sasada-cam/racklift5/models/v3/components/README.md

# RackLift5 v3 - component list

129 unique parts, one STEP + STL each (mm, bounding-box corner at the origin; bought parts are simplified envelopes). Quantities are for the whole system: 3 rows x 4 racks, 3 docks, 1 cart, 1 robot. Generated by `cad/export_v3_components.py`; see also `models/v3/assembly/` for the assembled poses.

## Baskets

| ID | part | qty | size mm | process / source |
|---|---|---|---|---|
| BAS01 | basket (stand-in for the real basket) | 55 | 260 x 180 x 110 | Buy (basket) |

## Covers

| ID | part | qty | size mm | process / source |
|---|---|---|---|---|
| COV01 | cover: front drive (servo 1 + belt) | 1 | 58 x 55 x 58 | 3D print (PETG), 2.4 mm walls, closed face down |
| COV02 | cover: jack motor | 3 | 71 x 66 x 56 | 3D print (PETG), 2.4 mm walls, closed face down |
| COV03 | cover: turn-drive cap | 1 | 47 x 36 x 46 | 3D print (PETG), 2.4 mm walls, closed face down |

## Dock (jack + raised floor)

| ID | part | qty | size mm | process / source |
|---|---|---|---|---|
| DOC01 | jack: NEMA17 stepper + 3:1 planetary gearhead | 3 | 73 x 42 x 42 | Buy (actuator) |
| DOC02 | jack: TR8x2 lead screw | 3 | 170 x 10 x 10 | Buy (TR8x2 lead screw) |
| DOC03 | jack: base plate (aluminium) | 3 | 270 x 214 x 6 | Aluminium plate / bar (laser cut, drill) |
| DOC04 | jack: bottom pivot lug | 6 | 16 x 8 x 16 | 3D print (PETG) |
| DOC05 | jack: bottom pivot shaft (fixed) | 3 | 6 x 167 x 6 | Steel rod / tube (cut, turn) |
| DOC06 | jack: centre pin shaft | 3 | 6 x 168 x 6 | Steel rod / tube (cut, turn) |
| DOC07 | jack: lead nut block (printed) | 3 | 16 x 16 x 21 | 3D print (PETG) |
| DOC08 | jack: limit switch (platform down) | 3 | 8 x 10 x 14 | Buy (sensor / switch) |
| DOC09 | jack: limit switch (platform up) | 3 | 8 x 10 x 14 | Buy (sensor / switch) |
| DOC10 | jack: motor bracket (printed) | 3 | 6 x 66 x 56 | 3D print (PETG) |
| DOC11 | jack: platform plate (8 mm aluminium) | 3 | 290 x 236 x 17 | Aluminium plate / bar (laser cut, drill) |
| DOC12 | jack: roller | 6 | 12 x 3 x 12 | Buy (wheel / roller) |
| DOC13 | jack: roller axle | 3 | 4 x 165 x 4 | Steel rod / tube (cut, turn) |
| DOC14 | jack: roller guide bar | 6 | 104 x 4 x 16 | Steel / aluminium flat bar (cut, drill) |
| DOC15 | jack: scissor arm (inner) | 6 | 184 x 8 x 14 | Aluminium flat bar 14 x 8 (cut, drill) |
| DOC16 | jack: scissor arm (outer) | 6 | 184 x 8 x 14 | Aluminium flat bar 14 x 8 (cut, drill) |
| DOC17 | jack: screw bearing block (printed) | 3 | 8 x 24 x 28 | 3D print (PETG) |
| DOC18 | jack: shaft coupling + index flag | 3 | 10 x 16 x 34 | Print, or buy a GT2 pulley / gear / coupling |
| DOC19 | jack: slider cross tube | 3 | 8 x 165 x 8 | Steel rod / tube (cut, turn) |
| DOC20 | jack: slider guide rail | 6 | 118 x 6 x 4 | Steel / aluminium flat bar (cut, drill) |
| DOC21 | jack: slider shoe (printed) | 6 | 24 x 6 x 11 | 3D print (PETG) |
| DOC22 | jack: top pivot lug | 6 | 16 x 6 x 16 | 3D print (PETG) |
| DOC23 | jack: top pivot shaft | 3 | 6 x 163 x 6 | Steel rod / tube (cut, turn) |
| DOC24 | raised floor: battens | 3 | 399 x 424 x 20 | Timber battens (cut) |
| DOC25 | raised floor: top plate (18 mm plywood) | 3 | 399 x 424 x 18 | Plywood (cut to size) |

## Locks (robot + cart)

| ID | part | qty | size mm | process / source |
|---|---|---|---|---|
| LCK01 | cart docking bar (printed, with the bolt socket) | 1 | 116 x 28 x 28 | 3D print (PETG) |
| LCK02 | cart lock pin + release tab (spring) | 1 | 40 x 74 x 40 | Steel rod / tube (cut, turn) |
| LCK03 | cart lock socket (printed, funnel lead-in, on the lower rail-end arm) | 3 | 30 x 26 x 65 | 3D print (PETG) |
| LCK04 | lock solenoid (docking bolt, push type) | 1 | 18 x 28 x 16 | Buy (actuator) |
| LCK05 | lock solenoid (release plunger, push type) | 1 | 28 x 21 x 16 | Buy (actuator) |
| LCK06 | lock solenoid bolt (docking, bullet nose) | 1 | 9 x 14 x 9 | Steel rod / tube (cut, turn) |
| LCK07 | lock solenoid bracket (docking bolt) | 1 | 24 x 6 x 24 | 3D print (PETG) |
| LCK08 | lock solenoid bracket (release plunger) | 1 | 36 x 6 x 24 | 3D print (PETG) |
| LCK09 | lock solenoid plunger (cart release) | 1 | 48 x 4 x 4 | Steel rod / tube (cut, turn) |

## Rack

| ID | part | qty | size mm | process / source |
|---|---|---|---|---|
| RAC01 | slotted angle rack (bay) | 12 | 382 x 234 x 1000 | Buy (slotted-angle rack) |

## Rails + crossings

| ID | part | qty | size mm | process / source |
|---|---|---|---|---|
| RAI01 | 50 mm turntable bearing | 24 | 50 x 8 x 50 | Buy (bearing) |
| RAI02 | V-slot rail (horizontal) | 18 | 324 x 20 x 20 | Aluminium extrusion (cut to length) |
| RAI03 | V-slot rail (horizontal) | 6 | 489 x 20 x 20 | Aluminium extrusion (cut to length) |
| RAI04 | V-slot rail (vertical) | 12 | 20 x 20 x 694 | Aluminium extrusion (cut to length) |
| RAI05 | V-slot rail (vertical, between crossings) | 12 | 20 x 20 x 145 | Aluminium extrusion (cut to length) |
| RAI06 | aluminium crossing bracket | 6 | 57 x 40 x 40 | Aluminium plate / bar (laser cut, drill) |
| RAI07 | aluminium crossing bracket | 18 | 182 x 40 x 40 | Aluminium plate / bar (laser cut, drill) |
| RAI08 | aluminium rail support (last stretch) | 6 | 38 x 40 x 40 | Aluminium plate / bar (laser cut, drill) |
| RAI09 | printed in-slot rack | 36 | 10 x 4 x 188 | Print fine (0.12 mm, 100 % infill) or order nylon (SLS) |
| RAI10 | printed in-slot rack | 30 | 10 x 4 x 188 | Print fine (0.12 mm, 100 % infill) or order nylon (SLS) |
| RAI11 | printed in-slot rack | 12 | 10 x 4 x 129 | Print fine (0.12 mm, 100 % infill) or order nylon (SLS) |
| RAI12 | printed in-slot rack | 12 | 10 x 4 x 145 | Print fine (0.12 mm, 100 % infill) or order nylon (SLS) |
| RAI13 | printed in-slot rack | 18 | 136 x 4 x 10 | Print fine (0.12 mm, 100 % infill) or order nylon (SLS) |
| RAI14 | printed in-slot rack | 6 | 113 x 4 x 10 | Print fine (0.12 mm, 100 % infill) or order nylon (SLS) |
| RAI15 | printed in-slot rack (cart) | 2 | 112 x 4 x 10 | Print fine (0.12 mm, 100 % infill) or order nylon (SLS) |
| RAI16 | printed in-slot rack (turntable) | 24 | 10 x 4 x 112 | Print fine (0.12 mm, 100 % infill) or order nylon (SLS) |
| RAI17 | printed rail bridge | 36 | 122 x 40 x 40 | 3D print (PETG) |
| RAI18 | rail end arm (from the rack end post) | 6 | 125 x 30 x 24 | Aluminium extrusion (cut to length) |
| RAI19 | rail piece on cart | 2 | 112 x 20 x 20 | Aluminium extrusion (cut to length) |
| RAI20 | rail piece on turntable | 24 | 20 x 20 x 112 | Aluminium extrusion (cut to length) |

## Robot body + hubs

| ID | part | qty | size mm | process / source |
|---|---|---|---|---|
| ROB01 | JGY-370 climb motor | 2 | 22 x 36 x 32 | Buy (actuator) |
| ROB02 | JGY-370 climb motor can | 2 | 24 x 24 x 30 | Buy (actuator) |
| ROB03 | JGY-370 swivel motor | 2 | 22 x 22 x 46 | Buy (actuator) |
| ROB04 | JGY-370 swivel motor can | 2 | 33 x 24 x 24 | Buy (actuator) |
| ROB05 | PTFE slide pad | 8 | 2 x 180 x 4 | Buy (PTFE pad) |
| ROB06 | V wheel | 8 | 24 x 10 x 24 | Buy (wheel / roller) |
| ROB07 | aluminium column bar 28 x 24 (replaces the printed column) | 1 | 28 x 24 x 299 | Aluminium bar 28 x 24 (cut to length, drill) |
| ROB08 | battery + electronics box (fixed counterweight) | 1 | 100 x 60 x 90 | Buy (battery + electronics box) |
| ROB09 | battery bracket | 1 | 56 x 24 x 30 | Aluminium plate / bar (laser cut, drill) |
| ROB10 | climber shaft | 2 | 13 x 6 x 6 | Steel rod / tube (cut, turn) |
| ROB11 | hub plate (6 mm aluminium) | 2 | 65 x 6 x 90 | Aluminium plate / bar (laser cut, drill) |
| ROB12 | printed climber pinion | 2 | 11 x 24 x 24 | Print fine (0.12 mm, 100 % infill) or order nylon (SLS) |
| ROB13 | printed hub cover | 2 | 94 x 12 x 94 | 3D print (PETG) |
| ROB14 | spacer | 8 | 10 x 6 x 10 | Steel rod / tube (cut, turn) |
| ROB15 | swivel axle | 2 | 16 x 29 x 16 | Steel rod / tube (cut, turn) |

## Transfer cart + beam

| ID | part | qty | size mm | process / source |
|---|---|---|---|---|
| CRT01 | cart frame (20x20 V-slot) | 1 | 126 x 280 x 408 | Aluminium extrusion (cut to length) |
| CRT02 | cart trolley plate | 2 | 8 x 44 x 88 | Aluminium plate / bar (laser cut, drill) |
| CRT03 | floor guide rail (guides only, no load) | 1 | 20 x 2040 x 20 | Aluminium extrusion (cut to length) |
| CRT04 | floor guide rollers (sideways only) | 2 | 36 x 16 x 20 | Buy (wheel / roller) |
| CRT05 | printed transfer rack segment (module 1.5) | 10 | 7 x 188 x 8 | Print fine (0.12 mm, 100 % infill) or order nylon (SLS) |
| CRT06 | printed transfer rack segment (module 1.5) | 1 | 7 x 151 x 8 | Print fine (0.12 mm, 100 % infill) or order nylon (SLS) |
| CRT07 | transfer beam (20x40 V-slot, carries the cart) | 1 | 20 x 2040 x 40 | Aluminium extrusion (cut to length) |
| CRT08 | transfer beam arm | 5 | 422 x 20 x 24 | Aluminium extrusion (cut to length) |
| CRT09 | transfer beam post (levelling foot) | 5 | 100 x 60 x 398 | Aluminium extrusion (cut to length) |
| CRT10 | trolley V-wheels (above + below the beam) | 2 | 28 x 44 x 80 | Buy (wheel / roller) |

## Tray + picker + drives

| ID | part | qty | size mm | process / source |
|---|---|---|---|---|
| PIC01 | GT2 25T pulley (servo 1) | 1 | 5 x 40 x 40 | Print, or buy a GT2 pulley / gear / coupling |
| PIC02 | GT2 33T pulley (stage-1 drive) | 2 | 4 x 24 x 24 | Print, or buy a GT2 pulley / gear / coupling |
| PIC03 | GT2 8T pulley (step-up, cross shaft) | 1 | 5 x 15 x 15 | Print, or buy a GT2 pulley / gear / coupling |
| PIC04 | GT2 belt (servo 2 -> right rod) | 1 | 269 x 4 x 11 | Buy (GT2 belt, cut to length) |
| PIC05 | GT2 belt (step-up 25T -> 8T) | 1 | 5 x 41 x 50 | Buy (GT2 belt, cut to length) |
| PIC06 | GT2 belt loop (stage 1) | 2 | 4 x 236 x 11 | Buy (GT2 belt, cut to length) |
| PIC07 | GT2 idler (stage-1 belt) | 2 | 4 x 24 x 24 | Print, or buy a GT2 pulley / gear / coupling |
| PIC08 | GT2 pulley (right rod) | 1 | 24 x 4 x 24 | Print, or buy a GT2 pulley / gear / coupling |
| PIC09 | GT2 pulley (servo 2) | 1 | 24 x 4 x 24 | Print, or buy a GT2 pulley / gear / coupling |
| PIC10 | N20 gear motor (turn drive, on the lift carriage) | 1 | 12 x 12 x 27 | Buy (actuator) |
| PIC11 | SG90 micro servo (turn pinion lift) | 1 | 12 x 23 x 22 | Buy (actuator) |
| PIC12 | arm drive cross shaft (both arms locked together) | 1 | 304 x 6 x 6 | Steel rod / tube (cut, turn) |
| PIC13 | bar load cell 5 kg + HX711 | 1 | 36 x 20 x 13 | Buy (sensor / switch) |
| PIC14 | belt anchor (inner bar) | 4 | 4 x 4 x 2 | 3D print (PETG) |
| PIC15 | belt anchor (outer bar) | 4 | 4 x 4 x 2 | 3D print (PETG) |
| PIC16 | finger drive gear (left rod) | 1 | 24 x 4 x 24 | Print, or buy a GT2 pulley / gear / coupling |
| PIC17 | finger drive gear (servo 2) | 1 | 24 x 4 x 24 | Print, or buy a GT2 pulley / gear / coupling |
| PIC18 | finger shaft bearing (inner bar) | 4 | 13 x 6 x 20 | 3D print (PETG) |
| PIC19 | finger shaft: fixed square rod | 2 | 5 x 221 x 5 | Steel rod / tube (cut, turn) |
| PIC20 | finger shaft: inner square tube | 2 | 11 x 192 x 11 | Steel rod / tube (cut, turn) |
| PIC21 | finger shaft: middle square tube | 2 | 8 x 198 x 8 | Steel rod / tube (cut, turn) |
| PIC22 | idler axle | 2 | 6 x 4 x 4 | Steel rod / tube (cut, turn) |
| PIC23 | limit switch (basket on tray) | 1 | 20 x 6 x 10 | Buy (sensor / switch) |
| PIC24 | plywood tray 12 mm | 1 | 292 x 224 x 12 | Plywood (cut to size) |
| PIC25 | printed arm post | 2 | 13 x 15 x 35 | 3D print (PETG) |
| PIC26 | printed arm post (rear, idler axle) | 2 | 13 x 12 x 35 | 3D print (PETG) |
| PIC27 | printed basket stop | 2 | 40 x 24 x 26 | 3D print (PETG) |
| PIC28 | printed flip finger (front) | 2 | 19 x 4 x 42 | 3D print (PETG) |
| PIC29 | printed flip finger (rear) | 2 | 19 x 4 x 42 | 3D print (PETG) |
| PIC30 | printed front post (rod + cross-shaft bearings) | 2 | 13 x 21 x 87 | 3D print (PETG) |
| PIC31 | printed lift carriage | 1 | 4 x 16 x 27 | 3D print (PETG) |
| PIC32 | printed stage-1 belt clamp (middle bar) | 2 | 5 x 10 x 30 | 3D print (PETG) |
| PIC33 | printed turn-drive mast | 1 | 79 x 24 x 98 | 3D print (PETG) |
| PIC34 | servo 1 bracket | 1 | 20 x 20 x 24 | Aluminium plate / bar (laser cut, drill) |
| PIC35 | servo 1: DS3218 270 deg (arm stroke) | 1 | 20 x 40 x 34 | Buy (actuator) |
| PIC36 | servo 2 bracket | 1 | 8 x 8 x 12 | Aluminium plate / bar (laser cut, drill) |
| PIC37 | servo 2 output shaft | 1 | 5 x 13 x 5 | Steel rod / tube (cut, turn) |
| PIC38 | servo 2: MG90S (all four fingers) | 1 | 23 x 28 x 12 | Buy (actuator) |
| PIC39 | stage-2 pulley (extend) | 2 | 4 x 16 x 16 | Print, or buy a GT2 pulley / gear / coupling |
| PIC40 | stage-2 pulley (retract) | 2 | 4 x 16 x 16 | Print, or buy a GT2 pulley / gear / coupling |
| PIC41 | telescopic arm, inner bar | 2 | 13 x 180 x 8 | Aluminium flat bar 13 x 8 (cut to length) |
| PIC42 | telescopic arm, middle bar | 2 | 13 x 180 x 8 | Aluminium flat bar 13 x 8 (cut to length) |
| PIC43 | telescopic arm, outer bar (fixed) | 2 | 13 x 180 x 8 | Aluminium flat bar 13 x 8 (cut to length) |
| PIC44 | tray bracket | 1 | 68 x 24 x 12 | Aluminium plate / bar (laser cut, drill) |
| PIC45 | turn drive pinion 16T (robot) | 1 | 27 x 27 x 8 | Print fine (0.12 mm, 100 % infill) or order nylon (SLS) |
| - | GT2 belt, stage 2 (6 mm), cut to the loop length | 4 | - | Buy (GT2 belt, cut to length) |

## Covers

| ID | part | qty | size mm | process / source |
|---|---|---|---|---|
| - | Cover screws: M3 x 16 chipboard (wood) screw, pan head - front drive cover into the plywood | 2 | - | Buy (hardware) |
| - | Cover screws: M3 x 12 machine screw, pan head - turn-drive cap (2) and the 3 jack motor covers (12) | 14 | - | Buy (hardware) |
| - | Cover nuts: M3 hex nut, standard or nylon-insert - caught in the printed slots / pockets | 14 | - | Buy (hardware) |
| - | Cover washers: M3 flat washer | 14 | - | Buy (hardware) |

## Rails + crossings

| ID | part | qty | size mm | process / source |
|---|---|---|---|---|
| - | Rack fixing: in-slot racks slide into the rail's front slot from the free end in order (press fit), one drop of cyanoacrylate per piece; end caps stop them at the free ends | as needed | - | Buy (hardware) |
| - | Rail / bracket fixing: M5 x 10 button screw + M5 slot T-nut (V-slot) - rail to bracket support plates and bridges | as needed | - | Buy (hardware) |
| - | Crossing bracket fixing: M5 x 12 screw + washer through the rack post flange (2 per post) + 4 x M4 x 12 bolts for the turntable bearing's fixed ring | as needed | - | Buy (hardware) |

## Hardware

| ID | part | qty | size mm | process / source |
|---|---|---|---|---|
| - | Fasteners: M3 / M4 / M5 screws, nuts, heat-set inserts, 4 mm dowel pins | as needed | - | Buy (assorted; count from the drawings) |
