sasada-cam/racklift5/models/parts_report.csv

group | part | qty | valid | solids | faces | volume_mm3 | petg_g_solid | size_x | size_y | size_z
Robot | R01_chassis | 1 | True | 1 | 53 | 178500.4 | 226.7 | 74.0 | 172.0 | 45.0
Robot | R02_climber_yoke | 1 | True | 1 | 28 | 22758.0 | 28.9 | 34.0 | 33.0 | 73.0
Robot | R03_climber_pinion_14T | 2 | True | 1 | 93 | 2280.5 | 2.9 | 24.0 | 23.6 | 11.0
Robot | R04_turn_pinion_12T | 1 | True | 1 | 76 | 2593.9 | 3.3 | 21.0 | 21.0 | 12.0
Robot | R05_hand_tray_arm_48T | 1 | True | 1 | 280 | 157104.7 | 199.5 | 209.0 | 118.5 | 20.0
Robot | R06_fork_crown | 1 | True | 1 | 56 | 44869.0 | 57.0 | 71.0 | 67.0 | 34.0
Robot | R07_tray_foot | 1 | True | 1 | 25 | 74386.6 | 94.5 | 148.0 | 110.0 | 48.0
Robot | R08_wheel_spacer_6mm | 4 | True | 1 | 4 | 338.9 | 0.4 | 10.0 | 10.0 | 6.0
Robot | R09_gantry_drill_jig | 1 | True | 1 | 18 | 20989.8 | 26.7 | 65.0 | 65.0 | 9.0
Robot | R10_hand_axle_spacer | 1 | True | 1 | 4 | 2246.3 | 2.9 | 14.0 | 14.0 | 22.8
Tray | T01_shoulder_tower | 1 | True | 1 | 37 | 183944.6 | 233.6 | 80.0 | 92.0 | 127.0
Tray | T02_upper_arm | 1 | True | 1 | 27 | 28466.1 | 36.2 | 214.0 | 32.0 | 8.0
Tray | T03_forearm_hook | 1 | True | 1 | 20 | 27292.1 | 34.7 | 207.0 | 32.0 | 47.0
Tray | T04_basket_stop | 2 | True | 1 | 16 | 10375.4 | 13.2 | 40.0 | 24.0 | 26.0
Tray | T05_cam_tof_bracket | 1 | True | 1 | 37 | 22684.0 | 28.8 | 48.0 | 108.0 | 11.0
Tray | T06_tof_down_mount | 1 | True | 1 | 18 | 6752.9 | 8.6 | 30.0 | 20.0 | 12.0
Junction | J01_turntable_rotor | 2 | True | 1 | 36 | 56270.0 | 71.5 | 44.0 | 210.0 | 8.0
Junction | J02_detent_spring | 4 | True | 1 | 12 | 2043.7 | 2.6 | 35.6 | 15.6 | 9.0
Junction | J03_torque_pin_sleeve | 4 | True | 1 | 4 | 2546.8 | 3.2 | 10.0 | 10.0 | 110.8
Junction | J04_stub_block | 2 | True | 1 | 8 | 6787.8 | 8.6 | 20.0 | 9.0 | 40.0
Junction | J05_base_spacer_22 | 10 | True | 1 | 4 | 3919.5 | 5.0 | 16.0 | 16.0 | 22.0
Junction | J06_rail_bridge | 4 | True | 1 | 38 | 42078.0 | 53.4 | 122.0 | 40.0 | 40.0
Rack | K_rack_turntable_half | 4 | True | 1 | 138 | 3102.7 | 3.9 | 10.0 | 149.8 | 4.3
Rack | K_rack_end | 2 | True | 1 | 142 | 3200.1 | 4.1 | 10.0 | 154.5 | 4.3
Rack | K_rack_33T | 6 | True | 1 | 142 | 3215.4 | 4.1 | 10.0 | 155.5 | 4.3
Rack | K_rack_18T_top | 2 | True | 1 | 82 | 1753.9 | 2.2 | 10.0 | 84.8 | 4.3
Rack | K_rack_horizontal | 1 | True | 1 | 126 | 2795.0 | 3.5 | 10.0 | 134.7 | 4.3
