sasada-cam/racklift5/(list of files, cad)

Other CAD files:
fem/out/V694.step
models/assembly/RackLift5_v2_reach.step
models/design/T05_cam_tof_bracket.step
models/print/K_rack_33T.step
models/v3/assembly/RackLift5_v3_transfer.step
models/v3/components/Baskets/BAS01_basket_stand_in_for_the_real_basket.step
models/v3/components/Covers/COV01_cover_front_drive_servo_1_belt.step
models/v3/components/Dock_jack_raised_floor/DOC03_jack_base_plate_aluminium.step
models/v3/design/V06_front_post.step
models/v3/print/V13_transfer_pinion_16T.step
fem/out/H324.step
models/assembly/RackLift5_v2_turning.step
models/design/R04_turn_pinion_12T.step
models/print/T04_basket_stop.step
models/v3/assembly/RackLift5_v3_dock.step
models/v3/components/Covers/COV03_cover_turn_drive_cap.step
models/v3/components/Dock_jack_raised_floor/DOC13_jack_roller_axle.step
models/v3/design/V29_transfer_rack_segment_40_teeth.step
models/v3/print/V09_inner_bar_bearing.step
models/assembly/RackLift5_v2_travel.step
models/design/T06_tof_down_mount.step
models/print/R01_chassis.step
models/v3/assembly/RackLift5_v3_swivel.step
models/v3/components/Covers/COV02_cover_jack_motor.step
models/v3/components/Dock_jack_raised_floor/DOC12_jack_roller.step
models/v3/design/V08_stage1_belt_clamp.step
models/v3/print/V32_cover_jack_motor.step
models/design/R09_gantry_drill_jig.step
models/print/K_rack_18T_top.step
models/v3/assembly/RackLift5_v3_travel.step
models/v3/components/Dock_jack_raised_floor/DOC04_jack_bottom_pivot_lug.step
models/v3/design/V24_cart_docking_bar.step
models/v3/print/V24_cart_docking_bar.step
models/design/R10_hand_axle_spacer.step
models/print/R03_climber_pinion_14T.step
models/v3/assembly/RackLift5_v3_pick.step
models/v3/components/Dock_jack_raised_floor/DOC11_jack_platform_plate_8_mm_aluminium.step
models/v3/design/V27_cart_lock_socket_funnel.step
models/v3/print/V19_jack_bearing_block.step
models/design/R03_climber_pinion_14T.step
models/print/R05_hand_tray_arm_48T.step
models/v3/components/Dock_jack_raised_floor/DOC10_jack_motor_bracket_printed.step
models/v3/design/V04_arm_post.step
models/v3/print/V06_front_post.step
models/design/T02_upper_arm.step
models/print/R07_tray_foot.step
models/v3/design/V03_flip_finger.step
models/design/R02_climber_yoke.step
models/print/T01_shoulder_tower.step
models/v3/design/V15_cart_trolley_plate.step
models/design/K_rack_33T.step
models/print/T02_upper_arm.step
models/v3/components/Dock_jack_raised_floor/DOC09_jack_limit_switch_platform_up.step
models/v3/design/V32_cover_jack_motor.step
models/v3/print/V16_lift_carriage.step
models/design/J06_rail_bridge.step
models/print/T06_tof_down_mount.step
models/v3/components/Dock_jack_raised_floor/DOC15_jack_scissor_arm_inner.step
models/v3/design/V19_jack_bearing_block.step
models/v3/print/V30_cover_front_drive.step
models/design/T04_basket_stop.step
models/print/J02_detent_spring.step
models/v3/components/Dock_jack_raised_floor/DOC01_jack_NEMA17_stepper_3_1_planetary_gearhead.step
models/v3/design/V28_in_slot_rack_segment_40_teeth.step
models/v3/print/V28_in_slot_rack_segment_40_teeth.step
models/design/T01_shoulder_tower.step
models/print/R10_hand_axle_spacer.step
models/v3/components/Dock_jack_raised_floor/DOC06_jack_centre_pin_shaft.step
models/v3/design/V18_jack_top_lug.step
models/v3/print/V18_jack_top_lug.step
models/design/R07_tray_foot.step
models/print/R02_climber_yoke.step
models/v3/components/Dock_jack_raised_floor/DOC05_jack_bottom_pivot_shaft_fixed.step
models/v3/print/V14_turn_drive_mast.step
models/design/T03_forearm_hook.step
models/print/J03_torque_pin_sleeve.step
models/v3/components/Dock_jack_raised_floor/DOC14_jack_roller_guide_bar.step
models/v3/design/V10_stage2_pulley.step
models/v3/print/V21_jack_slider_shoe.step
models/design/J02_detent_spring.step
models/print/T03_forearm_hook.step
models/v3/components/Dock_jack_raised_floor/DOC08_jack_limit_switch_platform_down.step
models/v3/design/V31_cover_turn_drive_cap.step
models/v3/print/V10_stage2_pulley.step
models/design/K_rack_horizontal.step
models/print/J04_stub_block.step
models/v3/components/Dock_jack_raised_floor/DOC16_jack_scissor_arm_outer.stl
models/v3/design/V16_lift_carriage.step
models/v3/print/V29_transfer_rack_segment_40_teeth.step
models/design/J01_turntable_rotor.step
models/print/K_rack_horizontal.step
models/v3/design/V09_inner_bar_bearing.step
models/v3/print/V20_jack_motor_bracket.step
models/design/J05_base_spacer_22.step
models/print/R04_turn_pinion_12T.step
models/v3/design/V23_jack_coupling_flag.step
models/v3/print/V26_release_solenoid_bracket.step
models/design/J04_stub_block.step
models/print/J06_rail_bridge.step
models/v3/design/V30_cover_front_drive.step
models/v3/print/V31_cover_turn_drive_cap.step
models/design/R08_wheel_spacer_6mm.step
models/print/K_rack_end.step
models/v3/print/V23_jack_coupling_flag.step
models/design/K_rack_end.step
models/print/R06_fork_crown.step
models/v3/design/V13_transfer_pinion_16T.step
models/v3/print/V15_cart_trolley_plate.step
models/design/K_rack_turntable_half.step
models/print/R08_wheel_spacer_6mm.step
models/v3/design/V01_hub_cover.step
models/v3/print/V17_jack_bottom_lug.step
models/design/R01_chassis.step
models/print/T05_cam_tof_bracket.step
models/v3/design/V20_jack_motor_bracket.step
models/v3/print/V01_hub_cover.step
models/design/R06_fork_crown.step
models/print/R09_gantry_drill_jig.step
models/v3/design/V14_turn_drive_mast.step
models/v3/print/V08_stage1_belt_clamp.step
models/design/J03_torque_pin_sleeve.step
models/print/J05_base_spacer_22.step
models/v3/design/V21_jack_slider_shoe.step
models/v3/print/V27_cart_lock_socket_funnel.step
models/design/R05_hand_tray_arm_48T.step
models/print/K_rack_turntable_half.step
models/v3/design/V07_rear_arm_post.step
models/v3/print/V04_arm_post.step
models/design/K_rack_18T_top.step
models/print/J01_turntable_rotor.step
models/v3/design/V26_release_solenoid_bracket.step
models/v3/print/V03_flip_finger.step
models/v3/design/V17_jack_bottom_lug.step
models/v3/print/V07_rear_arm_post.step
archive/v1/racklift_assembly_preview.stl
archive/v1/stl/01_rack_segment_L.stl
archive/v1/stl/01_rack_segment_R.stl
archive/v1/stl/02_pinion_m1.5_14T.stl
archive/v1/stl/03_rail_mount_A.stl
archive/v1/stl/03_rail_mount_B.stl
archive/v1/stl/04_carriage_bracket_L.stl
archive/v1/stl/04_carriage_bracket_R.stl
archive/v1/stl/05_deck_hanger_L.stl
archive/v1/stl/05_deck_hanger_R.stl
archive/v1/stl/06_wheel_spacer_6mm.stl
archive/v1/stl/07_gantry_drill_jig.stl
archive/v1/stl/08_shoulder_tower.stl
archive/v1/stl/09_upper_arm.stl
archive/v1/stl/10_forearm_hook.stl
archive/v1/stl/11_basket_stop.stl
archive/v1/stl/12_cam_tof_bracket.stl
archive/v1/stl/13_tof_down_mount.stl
archive/v2_original_stl/J01_turntable_rotor.stl
archive/v2_original_stl/J02_detent_spring.stl
archive/v2_original_stl/J03_torque_pin_sleeve.stl
archive/v2_original_stl/J04_stub_block.stl
archive/v2_original_stl/J05_base_spacer_22.stl
archive/v2_original_stl/J06_rail_bridge.stl
archive/v2_original_stl/K_rack_18T_top.stl
archive/v2_original_stl/K_rack_33T.stl
archive/v2_original_stl/K_rack_end.stl
archive/v2_original_stl/K_rack_horizontal.stl
archive/v2_original_stl/K_rack_turntable_half.stl
archive/v2_original_stl/R01_chassis.stl
archive/v2_original_stl/R02_climber_yoke.stl
archive/v2_original_stl/R03_climber_pinion_14T.stl
archive/v2_original_stl/R04_turn_pinion_12T.stl
archive/v2_original_stl/R05_hand_tray_arm_48T.stl
archive/v2_original_stl/R06_fork_crown.stl
archive/v2_original_stl/R07_tray_foot.stl
archive/v2_original_stl/R08_wheel_spacer_6mm.stl
archive/v2_original_stl/R09_gantry_drill_jig.stl
archive/v2_original_stl/R10_hand_axle_spacer.stl
archive/v2_original_stl/T01_shoulder_tower.stl
archive/v2_original_stl/T02_upper_arm.stl
archive/v2_original_stl/T03_forearm_hook.stl
archive/v2_original_stl/T04_basket_stop.stl
archive/v2_original_stl/T05_cam_tof_bracket.stl
archive/v2_original_stl/T06_tof_down_mount.stl
models/assembly/RackLift5_v2_reach.FCStd
models/assembly/RackLift5_v2_travel.FCStd
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
