sasada-cam/racklift5/docs/design/002-manufacturing-plan.md

# 002 - Manufacturing plan (v3)

Generated by `cad/make_manufacturing_plan.py` from `models/v3/components/BOM_v3.csv`, so it always matches the CAD. Everything here is a **suggestion** from the geometry: nothing has been priced, sourced or test-printed, and tolerances and strengths are typical values, not measurements. Part IDs are the ones in the BOM and the file names.

## 1. How to decide: print, cut, machine or buy

Print what is cheap to get wrong (covers, brackets, belt clamps). Buy or cut anything structural, long or precise. Print a first article, measure it, and only then order a batch.

| Process | Typical accuracy | Notes |
|---|---|---|
| Home FDM print (PETG) | +-0.2 to 0.3 mm; add 0.2 mm clearance on mating faces | weakest between layers (about half the strength across them) |
| Print fine (0.12 mm layers, 100 % infill) | +-0.15 mm; check backlash on a test pair | gears and racks |
| Outsourced nylon print (SLS / MJF, PA12) | +-0.3 mm (about +-0.1 with a good bureau) | even strength in all directions; no supports |
| Laser-cut or waterjet sheet / bar | +-0.1 to 0.2 mm; holes can be cut at final size | brackets, plates, scissor arms |
| CNC machined / turned | +-0.05 mm or better | pins, sockets, pivots, bearing seats |
| Off-the-shelf | per the datasheet | extrusion, motors, bearings, wheels, belts, hardware |

## 2. Printer and part size

Assumed printer: **220 x 220 x 250 mm, PETG** (change `PRINT_BED` in `params_v3.py`; the export fails if a printed part is bigger). Of the 50 part types that are printed (or print-or-buy), **0 do not fit**.

**What the CAD and the sim now do for printing** (done in `generator/assembly_v3.py`, so the MuJoCo model has the same parts):
- **Racks in segments:** every printed rack is cut into pieces of 40 whole teeth (188.5 mm) so the pitch carries across the joints; the earlier 690 / 481 / 318 mm in-slot racks and the 2 m transfer rack could not be printed whole.
- **Tooth phase made exact:** the crossing piece is symmetric (a tooth space at its centre), the gaps are 1.0 mm and the distances are whole pitches, so the comb is continuous through every crossing (it was 2 mm = 42 % of a pitch out for the horizontal rails).
- **Rails supported:** a laser-cut aluminium bracket per crossing (bearing plate, stems to the posts on both sides, a support for each rail end next to the crossing piece), I-shaped supports where the last stretch passes a post, and a rail bridge half-way up the vertical rail between the two crossings.
- **Column:** now an aluminium bar 28 x 24 x 300 instead of a 300 mm printed part.
- **Thin loaded parts thickened:** solenoid brackets 4 -> 6 mm, jack top lugs 4 -> 6 mm and bottom lugs 6 -> 8 mm, jack motor bracket 4 -> 6 mm, lift carriage 2 -> 4 mm.
- **Bores:** the stage-2 pulleys have a 4 mm axle bore (and bigger index holes); the flip-finger collar is 19.2 mm with a square hole for the tube; the finger shaft is 2 mm higher to make room.
- **Export:** each printed part is laid flat on its largest face (good layer direction) and checked against the bed.
- **Still not done:** the screw and bolt holes (to be drawn per part), the fork or slot that holds the stage-2 pulleys in the middle bar, and the flip fingers stay 4 mm (the gap behind the basket is only 8 mm): print them in nylon or on their side and check them first.

## 3. Joints between printed pieces (modular parts)

**Hybrid joints.** Use plastic shapes to align and to take shear, and steel hardware to clamp. Never rely on a plastic-only joint in a load path.

| Joint | Use for | Do not use for |
|---|---|---|
| Dovetail or stepped lap in the plastic | aligning, taking shear and twist | pulling apart (it only locks one way) |
| Steel 4 mm dowel pins | taking shear off the plastic, exact alignment | clamping |
| M3 / M4 bolt + heat-set brass insert or captured nut | clamping, repeated assembly | printed threads (they strip) |
| Plastic snap-fits / LEGO studs | covers, light alignment | anything that carries load (they creep and shear) |

Rules: cut where the bending moment is low; lap length >= 3x the thickness; two bolts + two dowels per joint; orient the layers so the bolts squeeze them (not peel them); PETG creeps under steady load, so keep stress low. Print a **coupon** of every new joint and pull-test it (a luggage scale is enough): require >= 4x the working load.

## 4. Check the strength first (shortlist)

Hand-calculate these, then run FEA on the worst three or four (layer direction matters: use about half the stated strength across layers):
1. thin printed parts: flip fingers (4 mm), jack pivot lugs (4 mm), solenoid brackets (4 mm), lift carriage;
2. the column at the tray bracket (bolt pull-out), if it is printed or split;
3. the transfer beam, its arms and posts (the cart and robot hang from them) and the rail-end arms (cantilever);
4. the lock pin / socket / bushing and the docking bolt: wear and a one-off shock when the cart arrives;
5. the scissor arms and pivots (about 350 N at the lowest angle), the lead nut block, and the gears (tooth bending).

## 5. Covers and fasteners

Printed covers protect the exposed drives and can be switched on / see-through / off in the viewer and the task page (separately for the robot and the docks). Every cover is held by **M3 screws, never by printed threads or snap-fits** (they wear out): the screw goes through a 3.4 mm clearance hole in the cover into an M3 nut in a printed slot or pocket, or (in plywood) a chipboard screw into a 2.5 mm pilot hole.

| Cover | Covers | Fixed to | Hardware |
|---|---|---|---|
| front drive | servo 1, step-up belt, cross-shaft end | tray plywood front edge | 2 x M3 x 16 chipboard screws |
| turn-drive cap | pinion motor, lift servo, carriage | two bosses on the mast | 2 x M3 x 12 + 2 nuts + 2 washers |
| jack motor (x3) | NEMA17 + gearhead | enlarged motor bracket | 4 x M3 x 12 + 4 nuts + 4 washers each |

**Not covered yet:** servo 2 and its gear pair (the corner is too tight against the finger shaft), the two lock solenoids, the climb motors and pinions in the hubs, and the scissor itself. They need their own cover design.

**Totals:** 14 x M3 x 12 machine screws, 2 x M3 x 16 chipboard screws, 14 M3 hex nuts, 14 M3 washers - buy about 20 % spares.

**Sourcing in Sri Lanka** (checked on the web on 2026-11-08; stock and prices change, and this is not a quote): M3 / M4 are standard metric sizes, which I expect any hardware or electronics shop to stock, but a search could not confirm local shops, so check before ordering. **Heat-set brass inserts** are available only as imports (Desertcart / Ubuy Sri Lanka): a 420-piece M3-M5 kit was about LKR 14,900 and a 400-piece kit about LKR 31,900; a 100-piece M3 pack (about LKR 940) was out of stock; the heat-press tool was about LKR 18,900. That is why the design uses plain nuts in printed pockets, and inserts are only an optional upgrade for parts you take apart often.
Sources: [M3 insert 100-pack](https://www.desertcart.lk/products/812137818-100-pack-m3-threaded-inserts-heat-set-inserts-m3x4x5-female.md), [M3-M5 insert kit](https://www.desertcart.lk/products/600782778-420pcs-m3-m4-m5-threaded-inserts-assortment-kit-for-3d.md), [heat-press insert tool](https://www.ubuy.com.lk/en/product/7VBIO3LMU-3dzwman-vertical-heat-pressing-machine-heat-set-insert-tool-brass-inserts-3d-printing-heat-set-insert-tip-for-thread-knu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).

## 6. Print settings

| Class | Settings |
|---|---|
| General parts | PETG, 0.2 mm layers, 4 walls, 40 % gyroid (as in the v2 release notes) |
| Gears, pinions, racks | 0.12 mm layers, 100 % infill, 4 walls; dry filament; or order PA12 nylon |
| Thin loaded parts (fingers, lugs, brackets) | 100 % infill, layers along the main bending direction, or nylon / aluminium |
| Mating holes | model 0.2 mm larger; ream bearing / pin holes to size |

## 7. Summary by process

| Process / source | part types | pieces |
|---|---|---|
| 3D print (PETG) | 24 | 99 |
| Steel rod / tube (cut, turn) | 17 | 40 |
| Aluminium extrusion (cut to length) | 12 | 93 |
| Print fine (0.12 mm, 100 % infill) or order nylon (SLS) | 12 | 154 |
| Buy (actuator) | 11 | 17 |
| Aluminium plate / bar (laser cut, drill) | 11 | 44 |
| Print, or buy a GT2 pulley / gear / coupling | 11 | 17 |
| Buy (hardware) | 7 | 44 |
| Buy (sensor / switch) | 4 | 8 |
| Buy (wheel / roller) | 4 | 18 |
| Buy (GT2 belt, cut to length) | 4 | 8 |
| 3D print (PETG), 2.4 mm walls, closed face down | 3 | 5 |
| Aluminium flat bar 13 x 8 (cut to length) | 3 | 6 |
| Steel / aluminium flat bar (cut, drill) | 2 | 12 |
| Aluminium flat bar 14 x 8 (cut, drill) | 2 | 12 |
| Plywood (cut to size) | 2 | 4 |
| Buy (basket) | 1 | 55 |
| Buy (TR8x2 lead screw) | 1 | 3 |
| Timber battens (cut) | 1 | 3 |
| Buy (slotted-angle rack) | 1 | 12 |
| Buy (bearing) | 1 | 24 |
| Buy (PTFE pad) | 1 | 8 |
| Aluminium bar 28 x 24 (cut to length, drill) | 1 | 1 |
| Buy (battery + electronics box) | 1 | 1 |
| Buy (assorted; count from the drawings) | 1 | - |

## 8. Part by part

### Baskets

| ID | part | qty | size mm | process / source | material | notes |
|---|---|---|---|---|---|---|
| BAS01 | basket (stand-in for the real basket) | 55 | 260 x 180 x 110 | Buy (basket) | the user's baskets | Stand-in; use your real baskets (the model assumes 260 x 180 x 110 mm). |

### Covers

| ID | part | qty | size mm | process / source | material | notes |
|---|---|---|---|---|---|---|
| COV01 | cover: front drive (servo 1 + belt) | 1 | 58 x 55 x 58 | 3D print (PETG), 2.4 mm walls, closed face down | PETG (PA12 nylon if ordered as SLS) | Screws into the plywood tray's front edge: 2 x M3 x 16 chipboard screws, 2.5 mm pilot holes. Lower edge 3.6 mm above a lowered basket. Print closed face down; the two ears may need a little support. |
| COV02 | cover: jack motor | 3 | 71 x 66 x 56 | 3D print (PETG), 2.4 mm walls, closed face down | PETG (PA12 nylon if ordered as SLS) | Stands on the floor; its flange meets the motor bracket: 4 x M3 x 12 screws + nuts (hex pockets on the bracket's back face). One per dock. |
| COV03 | cover: turn-drive cap | 1 | 47 x 36 x 46 | 3D print (PETG), 2.4 mm walls, closed face down | PETG (PA12 nylon if ordered as SLS) | Sits on the two mast bosses: M3 x 12 screw from the top into an M3 nut in the boss's side slot. Notch in the left wall for the mast arm. |
| - | Cover screws: M3 x 16 chipboard (wood) screw, pan head - front drive cover into the plywood | 2 | - | Buy (hardware) | off-the-shelf |  |
| - | Cover screws: M3 x 12 machine screw, pan head - turn-drive cap (2) and the 3 jack motor covers (12) | 14 | - | Buy (hardware) | off-the-shelf |  |
| - | Cover nuts: M3 hex nut, standard or nylon-insert - caught in the printed slots / pockets | 14 | - | Buy (hardware) | off-the-shelf |  |
| - | Cover washers: M3 flat washer | 14 | - | Buy (hardware) | off-the-shelf |  |

### Dock (jack + raised floor)

| ID | part | qty | size mm | process / source | material | notes |
|---|---|---|---|---|---|---|
| DOC01 | jack: NEMA17 stepper + 3:1 planetary gearhead | 3 | 73 x 42 x 42 | Buy (actuator) | off-the-shelf |  |
| DOC02 | jack: TR8x2 lead screw | 3 | 170 x 10 x 10 | Buy (TR8x2 lead screw) | off-the-shelf | TR8x2; support the free end in the printed bearing block; grease. |
| DOC03 | jack: base plate (aluminium) | 3 | 270 x 214 x 6 | Aluminium plate / bar (laser cut, drill) | 5052 / 6061 aluminium sheet or plate |  |
| DOC04 | jack: bottom pivot lug | 6 | 16 x 8 x 16 | 3D print (PETG) | PETG (PA12 nylon if ordered as SLS) | Thin (4-6 mm) and loaded by the scissor: check stress first, or make them from 4 mm aluminium. |
| DOC05 | jack: bottom pivot shaft (fixed) | 3 | 6 x 167 x 6 | Steel rod / tube (cut, turn) | steel rod / tube (hardened or silver steel where it slides) |  |
| DOC06 | jack: centre pin shaft | 3 | 6 x 168 x 6 | Steel rod / tube (cut, turn) | steel rod / tube (hardened or silver steel where it slides) |  |
| DOC07 | jack: lead nut block (printed) | 3 | 16 x 16 x 21 | 3D print (PETG) | PETG (PA12 nylon if ordered as SLS) |  |
| DOC08 | jack: limit switch (platform down) | 3 | 8 x 10 x 14 | Buy (sensor / switch) | off-the-shelf |  |
| DOC09 | jack: limit switch (platform up) | 3 | 8 x 10 x 14 | Buy (sensor / switch) | off-the-shelf |  |
| DOC10 | jack: motor bracket (printed) | 3 | 6 x 66 x 56 | 3D print (PETG) | PETG (PA12 nylon if ordered as SLS) | 4 hex nut pockets (5.8 mm across flats, 2.6 mm deep) on the back face for the motor cover's screws; plate 66 x 56 mm. |
| DOC11 | jack: platform plate (8 mm aluminium) | 3 | 290 x 236 x 17 | Aluminium plate / bar (laser cut, drill) | 5052 / 6061 aluminium sheet or plate |  |
| DOC12 | jack: roller | 6 | 12 x 3 x 12 | Buy (wheel / roller) | off-the-shelf |  |
| DOC13 | jack: roller axle | 3 | 4 x 165 x 4 | Steel rod / tube (cut, turn) | steel rod / tube (hardened or silver steel where it slides) |  |
| DOC14 | jack: roller guide bar | 6 | 104 x 4 x 16 | Steel / aluminium flat bar (cut, drill) | steel or aluminium flat bar |  |
| DOC15 | jack: scissor arm (inner) | 6 | 184 x 8 x 14 | Aluminium flat bar 14 x 8 (cut, drill) | 6061 aluminium flat bar | Drill both arms of a pair together: pivot holes 6 mm H9. Deburr; they carry bending at the pivots. |
| DOC16 | jack: scissor arm (outer) | 6 | 184 x 8 x 14 | Aluminium flat bar 14 x 8 (cut, drill) | 6061 aluminium flat bar | Drill both arms of a pair together: pivot holes 6 mm H9. Deburr; they carry bending at the pivots. |
| DOC17 | jack: screw bearing block (printed) | 3 | 8 x 24 x 28 | 3D print (PETG) | PETG (PA12 nylon if ordered as SLS) |  |
| DOC18 | jack: shaft coupling + index flag | 3 | 10 x 16 x 34 | Print, or buy a GT2 pulley / gear / coupling | PETG (PA12 nylon if ordered as SLS) |  |
| DOC19 | jack: slider cross tube | 3 | 8 x 165 x 8 | Steel rod / tube (cut, turn) | steel rod / tube (hardened or silver steel where it slides) |  |
| DOC20 | jack: slider guide rail | 6 | 118 x 6 x 4 | Steel / aluminium flat bar (cut, drill) | steel or aluminium flat bar |  |
| DOC21 | jack: slider shoe (printed) | 6 | 24 x 6 x 11 | 3D print (PETG) | PETG (PA12 nylon if ordered as SLS) |  |
| DOC22 | jack: top pivot lug | 6 | 16 x 6 x 16 | 3D print (PETG) | PETG (PA12 nylon if ordered as SLS) | Thin (4-6 mm) and loaded by the scissor: check stress first, or make them from 4 mm aluminium. |
| DOC23 | jack: top pivot shaft | 3 | 6 x 163 x 6 | Steel rod / tube (cut, turn) | steel rod / tube (hardened or silver steel where it slides) |  |
| DOC24 | raised floor: battens | 3 | 399 x 424 x 20 | Timber battens (cut) | pine battens | Level to the jack's lowered platform (38 mm top); screw the plate to the battens. |
| DOC25 | raised floor: top plate (18 mm plywood) | 3 | 399 x 424 x 18 | Plywood (cut to size) | birch plywood | Level to the jack's lowered platform (38 mm top); screw the plate to the battens. |

### Locks (robot + cart)

| ID | part | qty | size mm | process / source | material | notes |
|---|---|---|---|---|---|---|
| LCK01 | cart docking bar (printed, with the bolt socket) | 1 | 116 x 28 x 28 | 3D print (PETG) | PETG (PA12 nylon if ordered as SLS) | Socket hole 11 mm with the funnel; fit a steel bushing. Bolt the ends to the cart frame posts. |
| LCK02 | cart lock pin + release tab (spring) | 1 | 40 x 74 x 40 | Steel rod / tube (cut, turn) | steel rod / tube (hardened or silver steel where it slides) | 10 mm, hardened, bullet nose; slides in a bush on the cart frame; spring-return. Chamfer the tip 30 deg. |
| LCK03 | cart lock socket (printed, funnel lead-in, on the lower rail-end arm) | 3 | 30 x 26 x 65 | 3D print (PETG) | PETG (PA12 nylon if ordered as SLS) | Hole 11 mm for the 10 mm pin; funnel mouth 25 mm. Press a hardened steel bushing in (the wear part). Keep the printed block as thick as shown. |
| LCK04 | lock solenoid (docking bolt, push type) | 1 | 18 x 28 x 16 | Buy (actuator) | off-the-shelf |  |
| LCK05 | lock solenoid (release plunger, push type) | 1 | 28 x 21 x 16 | Buy (actuator) | off-the-shelf |  |
| LCK06 | lock solenoid bolt (docking, bullet nose) | 1 | 9 x 14 x 9 | Steel rod / tube (cut, turn) | steel rod / tube (hardened or silver steel where it slides) | 9 mm hardened steel, bullet nose; the plunger is pushed by a push-type solenoid: check its force and stroke. |
| LCK07 | lock solenoid bracket (docking bolt) | 1 | 24 x 6 x 24 | 3D print (PETG) | PETG (PA12 nylon if ordered as SLS) |  |
| LCK08 | lock solenoid bracket (release plunger) | 1 | 36 x 6 x 24 | 3D print (PETG) | PETG (PA12 nylon if ordered as SLS) |  |
| LCK09 | lock solenoid plunger (cart release) | 1 | 48 x 4 x 4 | Steel rod / tube (cut, turn) | steel rod / tube (hardened or silver steel where it slides) | 9 mm hardened steel, bullet nose; the plunger is pushed by a push-type solenoid: check its force and stroke. |

### Rack

| ID | part | qty | size mm | process / source | material | notes |
|---|---|---|---|---|---|---|
| RAC01 | slotted angle rack (bay) | 12 | 382 x 234 x 1000 | Buy (slotted-angle rack) | off-the-shelf |  |

### Rails + crossings

| ID | part | qty | size mm | process / source | material | notes |
|---|---|---|---|---|---|---|
| RAI01 | 50 mm turntable bearing | 24 | 50 x 8 x 50 | Buy (bearing) | off-the-shelf |  |
| RAI02 | V-slot rail (horizontal) | 18 | 324 x 20 x 20 | Aluminium extrusion (cut to length) | 6063 aluminium extrusion (V-slot) | Cut square (+-0.2 mm) and deburr; order stock lengths (2 m for the beam and floor rail). |
| RAI03 | V-slot rail (horizontal) | 6 | 489 x 20 x 20 | Aluminium extrusion (cut to length) | 6063 aluminium extrusion (V-slot) | Cut square (+-0.2 mm) and deburr; order stock lengths (2 m for the beam and floor rail). |
| RAI04 | V-slot rail (vertical) | 12 | 20 x 20 x 694 | Aluminium extrusion (cut to length) | 6063 aluminium extrusion (V-slot) | Cut square (+-0.2 mm) and deburr; order stock lengths (2 m for the beam and floor rail). |
| RAI05 | V-slot rail (vertical, between crossings) | 12 | 20 x 20 x 145 | Aluminium extrusion (cut to length) | 6063 aluminium extrusion (V-slot) | Cut square (+-0.2 mm) and deburr; order stock lengths (2 m for the beam and floor rail). |
| RAI06 | aluminium crossing bracket | 6 | 57 x 40 x 40 | Aluminium plate / bar (laser cut, drill) | 5052 / 6061 aluminium sheet or plate |  |
| RAI07 | aluminium crossing bracket | 18 | 182 x 40 x 40 | Aluminium plate / bar (laser cut, drill) | 5052 / 6061 aluminium sheet or plate |  |
| RAI08 | aluminium rail support (last stretch) | 6 | 38 x 40 x 40 | Aluminium plate / bar (laser cut, drill) | 5052 / 6061 aluminium sheet or plate |  |
| RAI09 | printed in-slot rack | 36 | 10 x 4 x 188 | Print fine (0.12 mm, 100 % infill) or order nylon (SLS) | PETG (PA12 nylon if ordered as SLS) | Printed in segments of 40 whole teeth (188.5 mm; shorter end pieces at the rail ends): the cut runs through a tooth space, so the 4.712 mm pitch carries across the joint. The V-slot keeps the pieces in line: butt joint + a drop of adhesive. One comb for the whole rail line: every piece starts 1.856 mm before its first tooth centre and ends 1.856 mm after its last, with a 1.0 mm gap at each crossing piece, so the pitch is 4.712 mm across every crossing (bay pitch = 93 pitches, hub spacing = 55, cart = 128). Slide the pieces in from the rail's free end, in order, press fit + one drop of cyanoacrylate each; cap the free ends (the top of each vertical rail, the cart end) with a printed end stop. |
| RAI10 | printed in-slot rack | 30 | 10 x 4 x 188 | Print fine (0.12 mm, 100 % infill) or order nylon (SLS) | PETG (PA12 nylon if ordered as SLS) | Printed in segments of 40 whole teeth (188.5 mm; shorter end pieces at the rail ends): the cut runs through a tooth space, so the 4.712 mm pitch carries across the joint. The V-slot keeps the pieces in line: butt joint + a drop of adhesive. One comb for the whole rail line: every piece starts 1.856 mm before its first tooth centre and ends 1.856 mm after its last, with a 1.0 mm gap at each crossing piece, so the pitch is 4.712 mm across every crossing (bay pitch = 93 pitches, hub spacing = 55, cart = 128). Slide the pieces in from the rail's free end, in order, press fit + one drop of cyanoacrylate each; cap the free ends (the top of each vertical rail, the cart end) with a printed end stop. |
| RAI11 | printed in-slot rack | 12 | 10 x 4 x 129 | Print fine (0.12 mm, 100 % infill) or order nylon (SLS) | PETG (PA12 nylon if ordered as SLS) | Printed in segments of 40 whole teeth (188.5 mm; shorter end pieces at the rail ends): the cut runs through a tooth space, so the 4.712 mm pitch carries across the joint. The V-slot keeps the pieces in line: butt joint + a drop of adhesive. One comb for the whole rail line: every piece starts 1.856 mm before its first tooth centre and ends 1.856 mm after its last, with a 1.0 mm gap at each crossing piece, so the pitch is 4.712 mm across every crossing (bay pitch = 93 pitches, hub spacing = 55, cart = 128). Slide the pieces in from the rail's free end, in order, press fit + one drop of cyanoacrylate each; cap the free ends (the top of each vertical rail, the cart end) with a printed end stop. |
| RAI12 | printed in-slot rack | 12 | 10 x 4 x 145 | Print fine (0.12 mm, 100 % infill) or order nylon (SLS) | PETG (PA12 nylon if ordered as SLS) | Printed in segments of 40 whole teeth (188.5 mm; shorter end pieces at the rail ends): the cut runs through a tooth space, so the 4.712 mm pitch carries across the joint. The V-slot keeps the pieces in line: butt joint + a drop of adhesive. One comb for the whole rail line: every piece starts 1.856 mm before its first tooth centre and ends 1.856 mm after its last, with a 1.0 mm gap at each crossing piece, so the pitch is 4.712 mm across every crossing (bay pitch = 93 pitches, hub spacing = 55, cart = 128). Slide the pieces in from the rail's free end, in order, press fit + one drop of cyanoacrylate each; cap the free ends (the top of each vertical rail, the cart end) with a printed end stop. |
| RAI13 | printed in-slot rack | 18 | 136 x 4 x 10 | Print fine (0.12 mm, 100 % infill) or order nylon (SLS) | PETG (PA12 nylon if ordered as SLS) | Printed in segments of 40 whole teeth (188.5 mm; shorter end pieces at the rail ends): the cut runs through a tooth space, so the 4.712 mm pitch carries across the joint. The V-slot keeps the pieces in line: butt joint + a drop of adhesive. One comb for the whole rail line: every piece starts 1.856 mm before its first tooth centre and ends 1.856 mm after its last, with a 1.0 mm gap at each crossing piece, so the pitch is 4.712 mm across every crossing (bay pitch = 93 pitches, hub spacing = 55, cart = 128). Slide the pieces in from the rail's free end, in order, press fit + one drop of cyanoacrylate each; cap the free ends (the top of each vertical rail, the cart end) with a printed end stop. |
| RAI14 | printed in-slot rack | 6 | 113 x 4 x 10 | Print fine (0.12 mm, 100 % infill) or order nylon (SLS) | PETG (PA12 nylon if ordered as SLS) | Printed in segments of 40 whole teeth (188.5 mm; shorter end pieces at the rail ends): the cut runs through a tooth space, so the 4.712 mm pitch carries across the joint. The V-slot keeps the pieces in line: butt joint + a drop of adhesive. One comb for the whole rail line: every piece starts 1.856 mm before its first tooth centre and ends 1.856 mm after its last, with a 1.0 mm gap at each crossing piece, so the pitch is 4.712 mm across every crossing (bay pitch = 93 pitches, hub spacing = 55, cart = 128). Slide the pieces in from the rail's free end, in order, press fit + one drop of cyanoacrylate each; cap the free ends (the top of each vertical rail, the cart end) with a printed end stop. |
| RAI15 | printed in-slot rack (cart) | 2 | 112 x 4 x 10 | Print fine (0.12 mm, 100 % infill) or order nylon (SLS) | PETG (PA12 nylon if ordered as SLS) | Printed in segments of 40 whole teeth (188.5 mm; shorter end pieces at the rail ends): the cut runs through a tooth space, so the 4.712 mm pitch carries across the joint. The V-slot keeps the pieces in line: butt joint + a drop of adhesive. One comb for the whole rail line: every piece starts 1.856 mm before its first tooth centre and ends 1.856 mm after its last, with a 1.0 mm gap at each crossing piece, so the pitch is 4.712 mm across every crossing (bay pitch = 93 pitches, hub spacing = 55, cart = 128). Slide the pieces in from the rail's free end, in order, press fit + one drop of cyanoacrylate each; cap the free ends (the top of each vertical rail, the cart end) with a printed end stop. |
| RAI16 | printed in-slot rack (turntable) | 24 | 10 x 4 x 112 | Print fine (0.12 mm, 100 % infill) or order nylon (SLS) | PETG (PA12 nylon if ordered as SLS) | Printed in segments of 40 whole teeth (188.5 mm; shorter end pieces at the rail ends): the cut runs through a tooth space, so the 4.712 mm pitch carries across the joint. The V-slot keeps the pieces in line: butt joint + a drop of adhesive. One comb for the whole rail line: every piece starts 1.856 mm before its first tooth centre and ends 1.856 mm after its last, with a 1.0 mm gap at each crossing piece, so the pitch is 4.712 mm across every crossing (bay pitch = 93 pitches, hub spacing = 55, cart = 128). Slide the pieces in from the rail's free end, in order, press fit + one drop of cyanoacrylate each; cap the free ends (the top of each vertical rail, the cart end) with a printed end stop. |
| RAI17 | printed rail bridge | 36 | 122 x 40 x 40 | 3D print (PETG) | PETG (PA12 nylon if ordered as SLS) |  |
| RAI18 | rail end arm (from the rack end post) | 6 | 125 x 30 x 24 | Aluminium extrusion (cut to length) | 6063 aluminium extrusion (V-slot) | Cantilevered ~120 mm from the rack end post: bolt through the post web with two bolts. |
| RAI19 | rail piece on cart | 2 | 112 x 20 x 20 | Aluminium extrusion (cut to length) | 6063 aluminium extrusion (V-slot) |  |
| RAI20 | rail piece on turntable | 24 | 20 x 20 x 112 | Aluminium extrusion (cut to length) | 6063 aluminium extrusion (V-slot) |  |
| - | Rack fixing: in-slot racks slide into the rail's front slot from the free end in order (press fit), one drop of cyanoacrylate per piece; end caps stop them at the free ends | as needed | - | Buy (hardware) | off-the-shelf | Printed in segments of 40 whole teeth (188.5 mm; shorter end pieces at the rail ends): the cut runs through a tooth space, so the 4.712 mm pitch carries across the joint. The V-slot keeps the pieces in line: butt joint + a drop of adhesive. One comb for the whole rail line: every piece starts 1.856 mm before its first tooth centre and ends 1.856 mm after its last, with a 1.0 mm gap at each crossing piece, so the pitch is 4.712 mm across every crossing (bay pitch = 93 pitches, hub spacing = 55, cart = 128). Slide the pieces in from the rail's free end, in order, press fit + one drop of cyanoacrylate each; cap the free ends (the top of each vertical rail, the cart end) with a printed end stop. |
| - | Rail / bracket fixing: M5 x 10 button screw + M5 slot T-nut (V-slot) - rail to bracket support plates and bridges | as needed | - | Buy (hardware) | off-the-shelf | Cut square (+-0.2 mm) and deburr; order stock lengths (2 m for the beam and floor rail). |
| - | Crossing bracket fixing: M5 x 12 screw + washer through the rack post flange (2 per post) + 4 x M4 x 12 bolts for the turntable bearing's fixed ring | as needed | - | Buy (hardware) | off-the-shelf |  |

### Robot body + hubs

| ID | part | qty | size mm | process / source | material | notes |
|---|---|---|---|---|---|---|
| ROB01 | JGY-370 climb motor | 2 | 22 x 36 x 32 | Buy (actuator) | off-the-shelf |  |
| ROB02 | JGY-370 climb motor can | 2 | 24 x 24 x 30 | Buy (actuator) | off-the-shelf |  |
| ROB03 | JGY-370 swivel motor | 2 | 22 x 22 x 46 | Buy (actuator) | off-the-shelf |  |
| ROB04 | JGY-370 swivel motor can | 2 | 33 x 24 x 24 | Buy (actuator) | off-the-shelf |  |
| ROB05 | PTFE slide pad | 8 | 2 x 180 x 4 | Buy (PTFE pad) | off-the-shelf |  |
| ROB06 | V wheel | 8 | 24 x 10 x 24 | Buy (wheel / roller) | off-the-shelf |  |
| ROB07 | aluminium column bar 28 x 24 (replaces the printed column) | 1 | 28 x 24 x 299 | Aluminium bar 28 x 24 (cut to length, drill) |  | Aluminium bar 28 x 24 x 300 (was a printed column that did not fit the bed): drill the bolt pattern; no joint needed. |
| ROB08 | battery + electronics box (fixed counterweight) | 1 | 100 x 60 x 90 | Buy (battery + electronics box) | off-the-shelf |  |
| ROB09 | battery bracket | 1 | 56 x 24 x 30 | Aluminium plate / bar (laser cut, drill) | 5052 / 6061 aluminium sheet or plate |  |
| ROB10 | climber shaft | 2 | 13 x 6 x 6 | Steel rod / tube (cut, turn) | steel rod / tube (hardened or silver steel where it slides) |  |
| ROB11 | hub plate (6 mm aluminium) | 2 | 65 x 6 x 90 | Aluminium plate / bar (laser cut, drill) | 5052 / 6061 aluminium sheet or plate | 6 mm; axle holes +-0.05 mm for the V-wheel eccentrics; the rail alignment depends on it. |
| ROB12 | printed climber pinion | 2 | 11 x 24 x 24 | Print fine (0.12 mm, 100 % infill) or order nylon (SLS) | PETG (PA12 nylon if ordered as SLS) | Bore for the 6 mm shaft with a flat (H8); 100 % infill; try a test pair for 0.1-0.2 mm backlash; metal gear if it wears. |
| ROB13 | printed hub cover | 2 | 94 x 12 x 94 | 3D print (PETG) | PETG (PA12 nylon if ordered as SLS) |  |
| ROB14 | spacer | 8 | 10 x 6 x 10 | Steel rod / tube (cut, turn) | steel rod / tube (hardened or silver steel where it slides) |  |
| ROB15 | swivel axle | 2 | 16 x 29 x 16 | Steel rod / tube (cut, turn) | steel rod / tube (hardened or silver steel where it slides) |  |

### Transfer cart + beam

| ID | part | qty | size mm | process / source | material | notes |
|---|---|---|---|---|---|---|
| CRT01 | cart frame (20x20 V-slot) | 1 | 126 x 280 x 408 | Aluminium extrusion (cut to length) | 6063 aluminium extrusion (V-slot) | Cut square (+-0.2 mm) and deburr; order stock lengths (2 m for the beam and floor rail). |
| CRT02 | cart trolley plate | 2 | 8 x 44 x 88 | Aluminium plate / bar (laser cut, drill) | 5052 / 6061 aluminium sheet or plate |  |
| CRT03 | floor guide rail (guides only, no load) | 1 | 20 x 2040 x 20 | Aluminium extrusion (cut to length) | 6063 aluminium extrusion (V-slot) |  |
| CRT04 | floor guide rollers (sideways only) | 2 | 36 x 16 x 20 | Buy (wheel / roller) | off-the-shelf |  |
| CRT05 | printed transfer rack segment (module 1.5) | 10 | 7 x 188 x 8 | Print fine (0.12 mm, 100 % infill) or order nylon (SLS) | PETG (PA12 nylon if ordered as SLS) | 40 whole teeth (188.5 mm); 10 full pieces + 1 shorter, butted on the 2 m beam (screw each piece to the beam). Or buy a module 1.5 rack. |
| CRT06 | printed transfer rack segment (module 1.5) | 1 | 7 x 151 x 8 | Print fine (0.12 mm, 100 % infill) or order nylon (SLS) | PETG (PA12 nylon if ordered as SLS) | 40 whole teeth (188.5 mm); 10 full pieces + 1 shorter, butted on the 2 m beam (screw each piece to the beam). Or buy a module 1.5 rack. |
| CRT07 | transfer beam (20x40 V-slot, carries the cart) | 1 | 20 x 2040 x 40 | Aluminium extrusion (cut to length) | 6063 aluminium extrusion (V-slot) | Cut square (+-0.2 mm) and deburr; order stock lengths (2 m for the beam and floor rail). |
| CRT08 | transfer beam arm | 5 | 422 x 20 x 24 | Aluminium extrusion (cut to length) | 6063 aluminium extrusion (V-slot) | Check the arm-to-post bolts: the whole cart rides on them. |
| CRT09 | transfer beam post (levelling foot) | 5 | 100 x 60 x 398 | Aluminium extrusion (cut to length) | 6063 aluminium extrusion (V-slot) | Levelling foot + base plate; bolt to the floor; set the beam height to the rails once. |
| CRT10 | trolley V-wheels (above + below the beam) | 2 | 28 x 44 x 80 | Buy (wheel / roller) | off-the-shelf |  |

### Tray + picker + drives

| ID | part | qty | size mm | process / source | material | notes |
|---|---|---|---|---|---|---|
| PIC01 | GT2 25T pulley (servo 1) | 1 | 5 x 40 x 40 | Print, or buy a GT2 pulley / gear / coupling | PETG (PA12 nylon if ordered as SLS) |  |
| PIC02 | GT2 33T pulley (stage-1 drive) | 2 | 4 x 24 x 24 | Print, or buy a GT2 pulley / gear / coupling | PETG (PA12 nylon if ordered as SLS) |  |
| PIC03 | GT2 8T pulley (step-up, cross shaft) | 1 | 5 x 15 x 15 | Print, or buy a GT2 pulley / gear / coupling | PETG (PA12 nylon if ordered as SLS) |  |
| PIC04 | GT2 belt (servo 2 -> right rod) | 1 | 269 x 4 x 11 | Buy (GT2 belt, cut to length) | GT2 belt, 6 mm, glass-fibre core |  |
| PIC05 | GT2 belt (step-up 25T -> 8T) | 1 | 5 x 41 x 50 | Buy (GT2 belt, cut to length) | GT2 belt, 6 mm, glass-fibre core |  |
| PIC06 | GT2 belt loop (stage 1) | 2 | 4 x 236 x 11 | Buy (GT2 belt, cut to length) | GT2 belt, 6 mm, glass-fibre core |  |
| PIC07 | GT2 idler (stage-1 belt) | 2 | 4 x 24 x 24 | Print, or buy a GT2 pulley / gear / coupling | PETG (PA12 nylon if ordered as SLS) |  |
| PIC08 | GT2 pulley (right rod) | 1 | 24 x 4 x 24 | Print, or buy a GT2 pulley / gear / coupling | PETG (PA12 nylon if ordered as SLS) |  |
| PIC09 | GT2 pulley (servo 2) | 1 | 24 x 4 x 24 | Print, or buy a GT2 pulley / gear / coupling | PETG (PA12 nylon if ordered as SLS) |  |
| PIC10 | N20 gear motor (turn drive, on the lift carriage) | 1 | 12 x 12 x 27 | Buy (actuator) | off-the-shelf |  |
| PIC11 | SG90 micro servo (turn pinion lift) | 1 | 12 x 23 x 22 | Buy (actuator) | off-the-shelf |  |
| PIC12 | arm drive cross shaft (both arms locked together) | 1 | 304 x 6 x 6 | Steel rod / tube (cut, turn) | steel rod / tube (hardened or silver steel where it slides) |  |
| PIC13 | bar load cell 5 kg + HX711 | 1 | 36 x 20 x 13 | Buy (sensor / switch) | off-the-shelf |  |
| PIC14 | belt anchor (inner bar) | 4 | 4 x 4 x 2 | 3D print (PETG) | PETG (PA12 nylon if ordered as SLS) |  |
| PIC15 | belt anchor (outer bar) | 4 | 4 x 4 x 2 | 3D print (PETG) | PETG (PA12 nylon if ordered as SLS) |  |
| PIC16 | finger drive gear (left rod) | 1 | 24 x 4 x 24 | Print, or buy a GT2 pulley / gear / coupling | PETG (PA12 nylon if ordered as SLS) |  |
| PIC17 | finger drive gear (servo 2) | 1 | 24 x 4 x 24 | Print, or buy a GT2 pulley / gear / coupling | PETG (PA12 nylon if ordered as SLS) |  |
| PIC18 | finger shaft bearing (inner bar) | 4 | 13 x 6 x 20 | 3D print (PETG) | PETG (PA12 nylon if ordered as SLS) |  |
| PIC19 | finger shaft: fixed square rod | 2 | 5 x 221 x 5 | Steel rod / tube (cut, turn) | steel rod / tube (hardened or silver steel where it slides) |  |
| PIC20 | finger shaft: inner square tube | 2 | 11 x 192 x 11 | Steel rod / tube (cut, turn) | steel rod / tube (hardened or silver steel where it slides) |  |
| PIC21 | finger shaft: middle square tube | 2 | 8 x 198 x 8 | Steel rod / tube (cut, turn) | steel rod / tube (hardened or silver steel where it slides) |  |
| PIC22 | idler axle | 2 | 6 x 4 x 4 | Steel rod / tube (cut, turn) | steel rod / tube (hardened or silver steel where it slides) |  |
| PIC23 | limit switch (basket on tray) | 1 | 20 x 6 x 10 | Buy (sensor / switch) | off-the-shelf | Stand-in; use your real baskets (the model assumes 260 x 180 x 110 mm). |
| PIC24 | plywood tray 12 mm | 1 | 292 x 224 x 12 | Plywood (cut to size) | birch plywood |  |
| PIC25 | printed arm post | 2 | 13 x 15 x 35 | 3D print (PETG) | PETG (PA12 nylon if ordered as SLS) |  |
| PIC26 | printed arm post (rear, idler axle) | 2 | 13 x 12 x 35 | 3D print (PETG) | PETG (PA12 nylon if ordered as SLS) |  |
| PIC27 | printed basket stop | 2 | 40 x 24 x 26 | 3D print (PETG) | PETG (PA12 nylon if ordered as SLS) | Stand-in; use your real baskets (the model assumes 260 x 180 x 110 mm). |
| PIC28 | printed flip finger (front) | 2 | 19 x 4 x 42 | 3D print (PETG) | PETG (PA12 nylon if ordered as SLS) | 4 mm thick, pushes a 2 kg basket: check stress first; consider 6 mm or nylon (SLS). Print on its side so layers run along the finger. |
| PIC29 | printed flip finger (rear) | 2 | 19 x 4 x 42 | 3D print (PETG) | PETG (PA12 nylon if ordered as SLS) | 4 mm thick, pushes a 2 kg basket: check stress first; consider 6 mm or nylon (SLS). Print on its side so layers run along the finger. |
| PIC30 | printed front post (rod + cross-shaft bearings) | 2 | 13 x 21 x 87 | 3D print (PETG) | PETG (PA12 nylon if ordered as SLS) |  |
| PIC31 | printed lift carriage | 1 | 4 x 16 x 27 | 3D print (PETG) | PETG (PA12 nylon if ordered as SLS) |  |
| PIC32 | printed stage-1 belt clamp (middle bar) | 2 | 5 x 10 x 30 | 3D print (PETG) | PETG (PA12 nylon if ordered as SLS) |  |
| PIC33 | printed turn-drive mast | 1 | 79 x 24 x 98 | 3D print (PETG) | PETG (PA12 nylon if ordered as SLS) | Two bosses with side slots for M3 nuts (the cap's screws): print the slots open to the side and drop the nuts in before fitting the cap. |
| PIC34 | servo 1 bracket | 1 | 20 x 20 x 24 | Aluminium plate / bar (laser cut, drill) | 5052 / 6061 aluminium sheet or plate |  |
| PIC35 | servo 1: DS3218 270 deg (arm stroke) | 1 | 20 x 40 x 34 | Buy (actuator) | off-the-shelf |  |
| PIC36 | servo 2 bracket | 1 | 8 x 8 x 12 | Aluminium plate / bar (laser cut, drill) | 5052 / 6061 aluminium sheet or plate |  |
| PIC37 | servo 2 output shaft | 1 | 5 x 13 x 5 | Steel rod / tube (cut, turn) | steel rod / tube (hardened or silver steel where it slides) |  |
| PIC38 | servo 2: MG90S (all four fingers) | 1 | 23 x 28 x 12 | Buy (actuator) | off-the-shelf |  |
| PIC39 | stage-2 pulley (extend) | 2 | 4 x 16 x 16 | Print, or buy a GT2 pulley / gear / coupling | PETG (PA12 nylon if ordered as SLS) |  |
| PIC40 | stage-2 pulley (retract) | 2 | 4 x 16 x 16 | Print, or buy a GT2 pulley / gear / coupling | PETG (PA12 nylon if ordered as SLS) |  |
| PIC41 | telescopic arm, inner bar | 2 | 13 x 180 x 8 | Aluminium flat bar 13 x 8 (cut to length) | 6061 aluminium flat bar |  |
| PIC42 | telescopic arm, middle bar | 2 | 13 x 180 x 8 | Aluminium flat bar 13 x 8 (cut to length) | 6061 aluminium flat bar |  |
| PIC43 | telescopic arm, outer bar (fixed) | 2 | 13 x 180 x 8 | Aluminium flat bar 13 x 8 (cut to length) | 6061 aluminium flat bar |  |
| PIC44 | tray bracket | 1 | 68 x 24 x 12 | Aluminium plate / bar (laser cut, drill) | 5052 / 6061 aluminium sheet or plate |  |
| PIC45 | turn drive pinion 16T (robot) | 1 | 27 x 27 x 8 | Print fine (0.12 mm, 100 % infill) or order nylon (SLS) | PETG (PA12 nylon if ordered as SLS) | Bore for the 6 mm shaft with a flat (H8); 100 % infill; try a test pair for 0.1-0.2 mm backlash; metal gear if it wears. |
| - | GT2 belt, stage 2 (6 mm), cut to the loop length | 4 | - | Buy (GT2 belt, cut to length) | GT2 belt, 6 mm, glass-fibre core |  |

### Hardware

| ID | part | qty | size mm | process / source | material | notes |
|---|---|---|---|---|---|---|
| - | Fasteners: M3 / M4 / M5 screws, nuts, heat-set inserts, 4 mm dowel pins | as needed | - | Buy (assorted; count from the drawings) | off-the-shelf |  |

## 9. Order of work

1. Build a **one-bay test rig** first (one rack bay, one vertical rail, the hubs, the tray and picker): it proves the printed parts, the fits and the picker before you buy three rows.
2. Print one of each small part; measure with calipers; test-fit the mating parts; only then print batches.
3. Order the long aluminium extrusion, the plates and the racks (or the nylon prints) in one go; they have the longest lead time.
4. Print and pull-test the joint coupons; run the stress shortlist (section 4) before the cart, beam and docks.
5. Replace any part that fails or wears with the next process up (print -> nylon -> machined) and note it here.
