sasada-cam/racklift5/(commit log)

2026-11-04 Organise RackLift5 v2 as a repository with exact B-rep CAD export
    - generator/: original parametric v2 source (params.py drives all dimensions)
    - cad/: build123d/OpenCascade drop-in backend for generator/csg.py, so the
    unchanged part code produces true solids; exporter + verification tools
    - models/: print-ready STEP/STL, design-frame STEP for FEA, 3 assembly poses
    (STEP + FreeCAD .FCStd), parts list and mass/volume report
    - docs/: renders and original release notes
    - archive/: v1 design and the original v2 mesh STLs (volume reference)
    - binary CAD/image files tracked with Git LFS
    [01_rack_segment_L.stl, 01_rack_segment_R.stl, 02_pinion_m1.5_14T.stl, 03_rail_mount_A.stl, 03_rail_mount_B.stl, 04_carriage_bracket_L.stl, 04_carriage_bracket_R.stl, 05_deck_hanger_L.stl]
2026-11-05 added updated design
    [RackLift5_v3_pick.step, RackLift5_v3_swivel.step, RackLift5_v3_transfer.step, RackLift5_v3_travel.step, V01_hub_cover.step, V01_hub_cover.stl, V02_column.step, V02_column.stl]
2026-11-05 v3: floor of racks, hanging transfer cart, docking stations with scissor jacks, rearrangeable slots
    - 3 rows x 4 racks; transfer cart hangs from a beam, lock pin at each row
    - docking station per row: motorized scissor jack + raised floor for home delivery
    - empty slots + tasks to move baskets, deliver to docks, receive parcels
    - tasks queue in any order; task page shows queue and messages
    - 152-pose collision check, CAD export with 5 assembly poses, README images
    [RackLift5_v3_dock.step, RackLift5_v3_pick.step, RackLift5_v3_swivel.step, RackLift5_v3_transfer.step, RackLift5_v3_travel.step, V01_hub_cover.step, V02_column.step, V03_flip_finger.step]
2026-11-05 v3: docks moved to the free floor right of the cart (no longer rails), lowered below the tray
    - dock platform under the tray's position on the cart: rails back to ~120 mm past the last rack
    - jack lowers to 38 mm (basket top 150 < tray bottom 166); servo 1 raised 34 mm so the robot rides over lowered docks
    - motor beside the platform (NEMA17 + 3:1 gearhead: ~350 N at the lowest arm angle)
    - swept clearance check (sampled poses can miss a thin basket wall) + controls that fail
    - 148-pose collision check, README, CAD, images
    [RackLift5_v3_dock.step, RackLift5_v3_pick.step, RackLift5_v3_swivel.step, RackLift5_v3_transfer.step, RackLift5_v3_travel.step, V01_hub_cover.step, V02_column.step, V03_flip_finger.step]
2026-11-05 v3: robot-side locks - docking bolt locks the robot to the cart, release solenoid unlocks the cart from the row
    - two push-type solenoids on the robot, the cart stays passive; interlock order: robot locks, cart releases, cart moves, cart locks, robot unlocks
    - docking bolt offset 25 mm (clears the vertical rails), socket bar in front of the rail line (17 mm stroke)
    - cart pin + release tab at z 134 below the battery sweep and the tray underside
    - swept (x,z) check of the ride-along parts against every row's socket and rail-end arms
    - 157-pose collision check, CAD (24 parts), README
    [RackLift5_v3_dock.step, RackLift5_v3_pick.step, RackLift5_v3_swivel.step, RackLift5_v3_transfer.step, RackLift5_v3_travel.step, V01_hub_cover.step, V02_column.step, V03_flip_finger.step]
2026-11-05 v3: drogue-style lead-in on both locks (funnel sockets, bullet-nosed pin and bolt) for wear and stopping error
    - cart pin socket: conical funnel mouth (capture +-7.5 mm, nose +-10), printed block with a replaceable steel bushing (design note)
    - docking bolt hole in the cart bar: funnel mouth (+-9 mm), bullet-nosed bolt
    - pin lowered to z 128 so the funnel head clears the release solenoid's sweep
    - 157-pose collision check + swept checks pass; CAD 25 parts
    [RackLift5_v3_dock.step, RackLift5_v3_pick.step, RackLift5_v3_swivel.step, RackLift5_v3_transfer.step, RackLift5_v3_travel.step, V01_hub_cover.step, V02_column.step, V03_flip_finger.step]
2026-11-08 v3: CAD model of every component (121 parts) + parts list; remove 10 mm rail stubs
    - cad/export_v3_components.py: each unique part as STEP + STL by category, BOM_v3.csv / README with qty, size, volume, suggested process
    - classification rules + unique IDs per category
    - horizontal rails no longer start with a 10 mm stub before the first crossing piece
    - assemblies regenerated
    [BAS01_basket_stand_in_for_the_real_basket.step, BAS01_basket_stand_in_for_the_real_basket.stl, BOM_v3.csv, CRT01_cart_frame_20x20_V_slot.step, CRT01_cart_frame_20x20_V_slot.stl, CRT02_cart_trolley_plate.step, CRT02_cart_trolley_plate.stl, CRT03_floor_guide_rail_guides_only_no_load.step]
2026-11-08 docs: manufacturing plan (002) generated from the parts list
    - print / cut / machine / buy per part, materials, tolerances and fit notes
    - part sizes vs a 220x220x250 printer: in-slot racks (690/481/318 mm), the 2 m transfer rack and the column do not fit
    - hybrid joint rules for modular printed parts, strength-check shortlist, print settings, order of work
2026-11-08 v3: made for printing - segmented racks, aluminium column, thicker thin parts, bores, bed check
    - printed racks (in-slot + transfer) in whole-tooth pieces of 40 teeth (188.5 mm): pitch carries across joints, V-slot keeps them in line
    - 300 mm column is now an aluminium bar; thicker solenoid brackets, jack lugs, motor bracket, lift carriage
    - axle bore in the stage-2 pulleys; square hole in the finger collars (shaft 2 mm higher)
    - part export orients each part flat on its largest face and fails if it does not fit PRINT_BED
    - same geometry in the MuJoCo model; 157-pose collision check passes; components (123) and plan regenerated
    [BAS01_basket_stand_in_for_the_real_basket.step, BOM_v3.csv, CRT01_cart_frame_20x20_V_slot.step, CRT02_cart_trolley_plate.step, CRT03_floor_guide_rail_guides_only_no_load.step, CRT04_floor_guide_rollers_sideways_only.step, CRT05_printed_transfer_rack_module_1_5.step, CRT05_printed_transfer_rack_module_1_5.stl]
2026-11-08 v3: printed covers (front drive, turn-drive cap, jack motor) with M3 screw fixing; toggle from the web page / viewer
    - 3 cover parts, 2.4 mm walls, closed face down when printed; screws into nuts in printed pockets or chipboard screws in plywood (no plastic threads)
    - mast bosses + nut slots, enlarged motor bracket with 4 nut pockets, plywood pilot holes
    - covers are named geoms; task page buttons and the 'c' key cycle solid / see-through / off for robot and dock covers
    - front cover raised for >3 mm over a lowered basket; 157-pose collision check + swept checks pass
    - hardware list (M3 screws, nuts, washers) and Sri Lanka sourcing note in the manufacturing plan; CAD 126 parts
    Co-Authored-B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
    [BAS01_basket_stand_in_for_the_real_basket.step, BOM_v3.csv, COV01_cover_front_drive_servo_1_belt.step, COV01_cover_front_drive_servo_1_belt.stl, COV02_cover_jack_motor.step, COV02_cover_jack_motor.stl, COV03_cover_turn_drive_cap.step, COV03_cover_turn_drive_cap.stl]
2026-11-08 v3: exact rack tooth phase across all crossings, aluminium crossing brackets + rail supports, mid-height rail bridge, rack fixing notes
    [BAS01_basket_stand_in_for_the_real_basket.step, BOM_v3.csv, COV01_cover_front_drive_servo_1_belt.step, COV02_cover_jack_motor.step, COV03_cover_turn_drive_cap.step, CRT01_cart_frame_20x20_V_slot.step, CRT01_cart_frame_20x20_V_slot.stl, CRT02_cart_trolley_plate.step]
2026-11-10 this will uoc clab pc branch
    [CRT01_cart_frame_20x20_V_slot.step, CRT01_cart_frame_20x20_V_slot.stl, CRT02_cart_trolley_plate.step, CRT02_cart_trolley_plate.stl, CRT03_floor_guide_rail_guides_only_no_load.step, CRT03_floor_guide_rail_guides_only_no_load.stl, CRT04_floor_guide_rollers_sideways_only.step, CRT04_floor_guide_rollers_sideways_only.stl]
2026-11-10 added v3 rail stress test (using CalculiX)
    [H324.step, V694.step]
